HAMES-6-4th/smart-bus-access/docs/인터페이스 & 모듈 설계서/시스템 설계서.pdf

시스템 설계서 - Bluetooth기반 교통약자용 버스 전동문 및 전동경사로 소규모 통합 제어 시스템

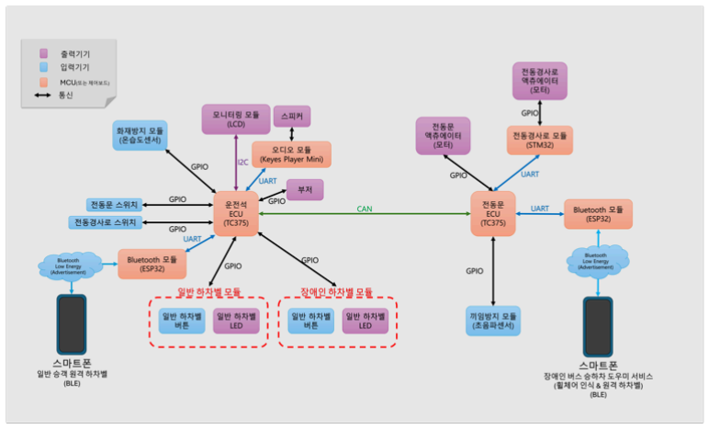
[picture p33: figure]
