HAMES-6-4th/smart-bus-access/docs/인터페이스 & 모듈 설계서/전동문 ECU.pdf

# 전동문 ECU - Bluetooth기반 교통약자용 버스 전동문 및 전동경사로 소규모 통 합 제어 시스템

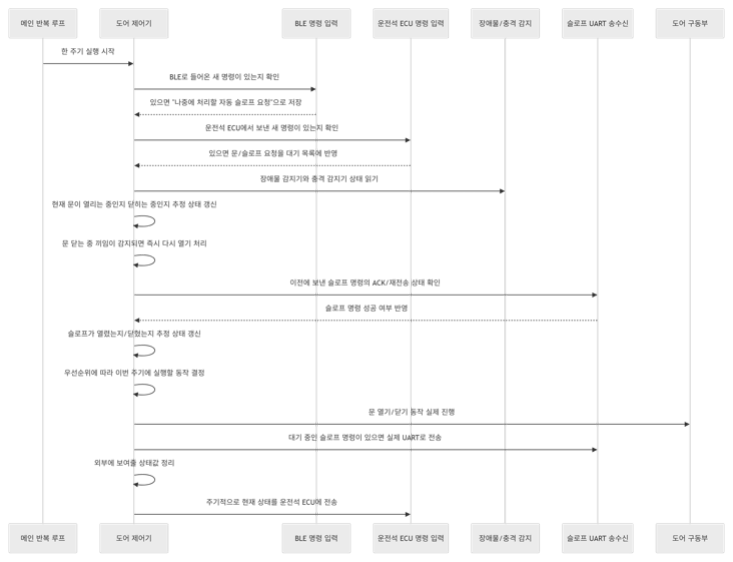
[picture p34: figure]

전체 시퀸스 다이어그램

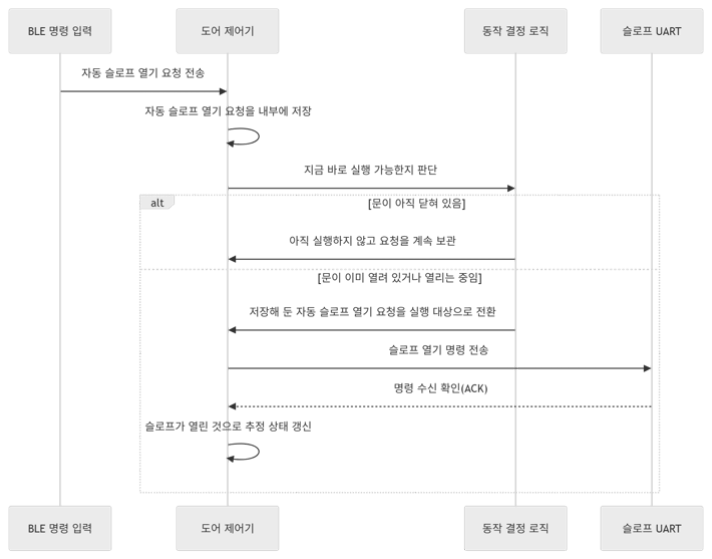
[picture p35: figure]

BLE 처리 구조

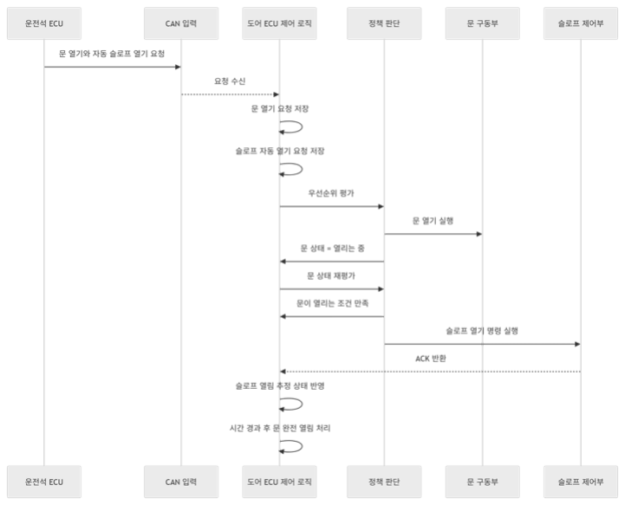
[picture p36: figure]

운전석 ECU에서 문 및 슬로프 열림 명령 수신 시

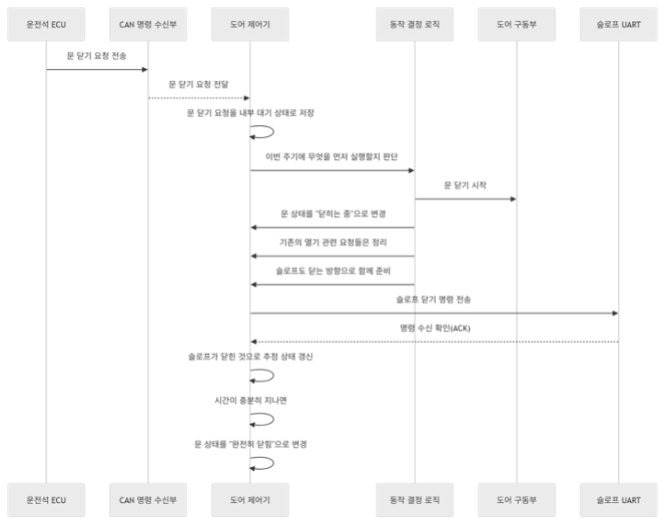
[picture p37: figure]

운전석 ECU에서 문 및 slope 닫힘 명령 수신 시

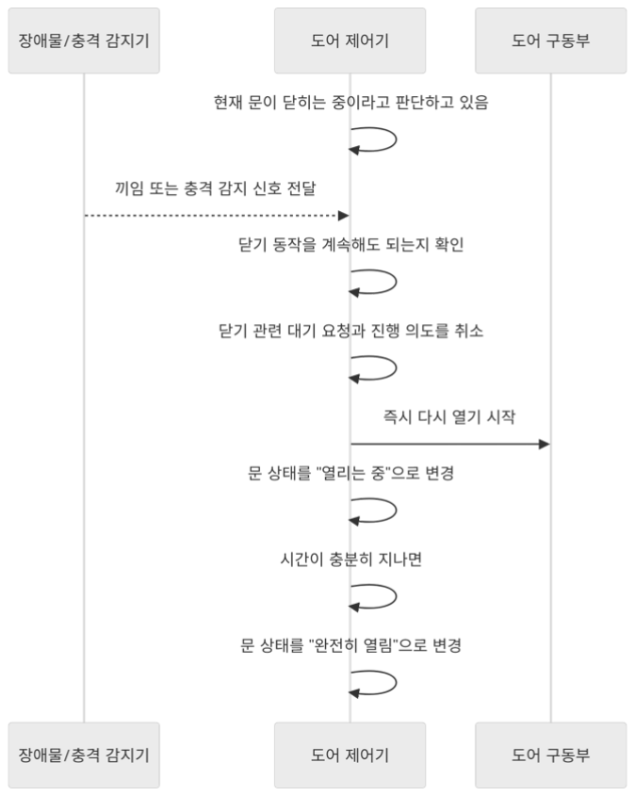
[picture p38: figure]

끼임 센서 다이어그램
