HAMES-6-4th/smart-bus-access/docs/인터페이스 & 모듈 설계서/핀 맵 & 레이아웃.pdf

핀 맵/레이아웃 - Bluetooth기반 교통약자용 버스 전동문 및 전동경사로 소규모 통합 제어 시스템

운전석 TC375 핀 맵

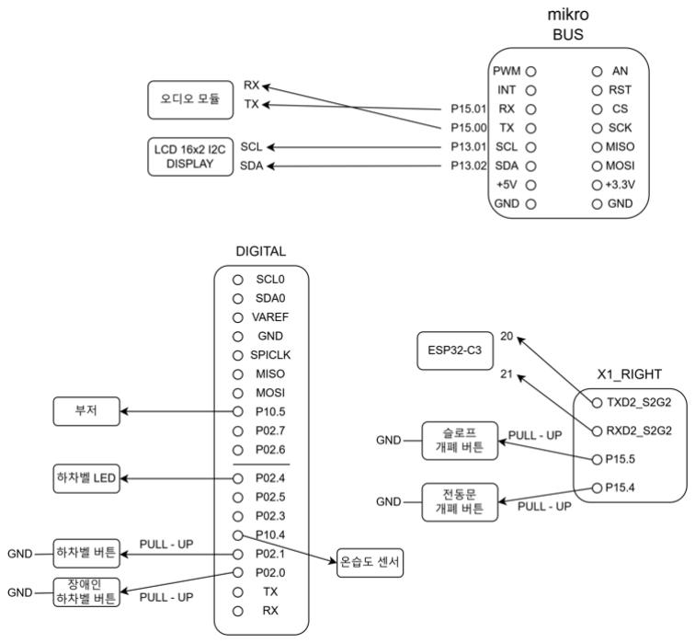
[picture p39: figure]
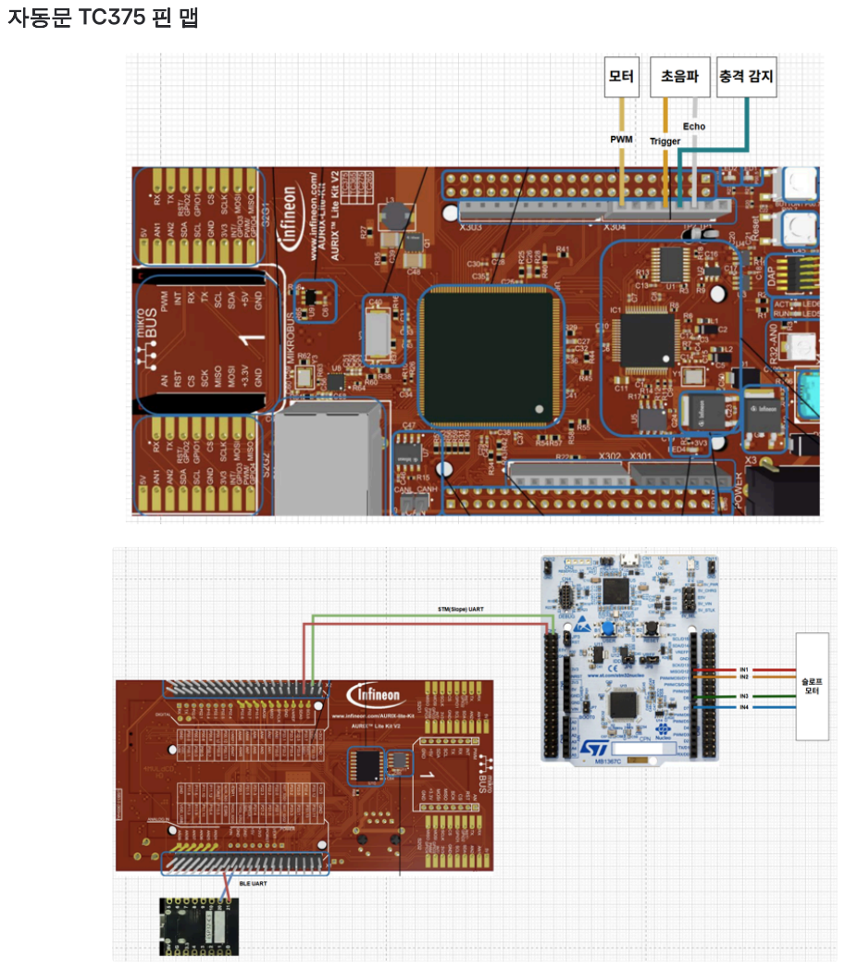
[picture p40: page 2]

자동문 TC375 핀 맵
