HAMES-6-4th/smart-bus-access/docs/최종 결과보고서/최종보고서.pdf

# Bluetooth기반 교통약자용

# 버스 전동문 및 전동경사로

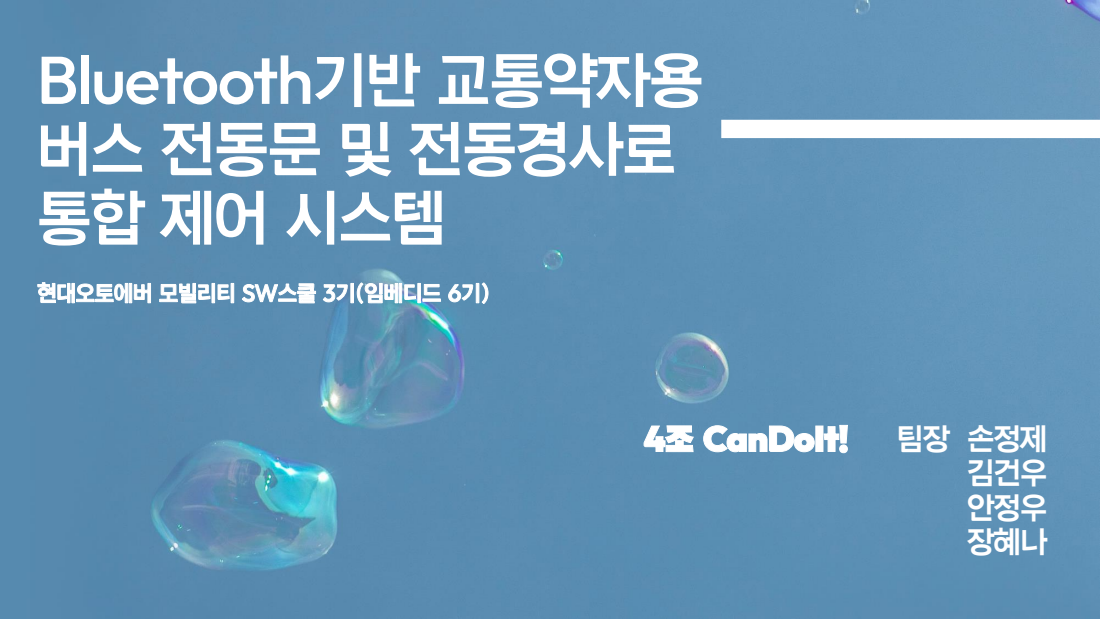
[picture p47: page 1]
4조 CanDoIt!; 팀장 손정제; 김건우 안정우 장혜나

통합 제어 시스템

현대오토에버 모빌리티 SW스쿨 3기(임베디드 6기)

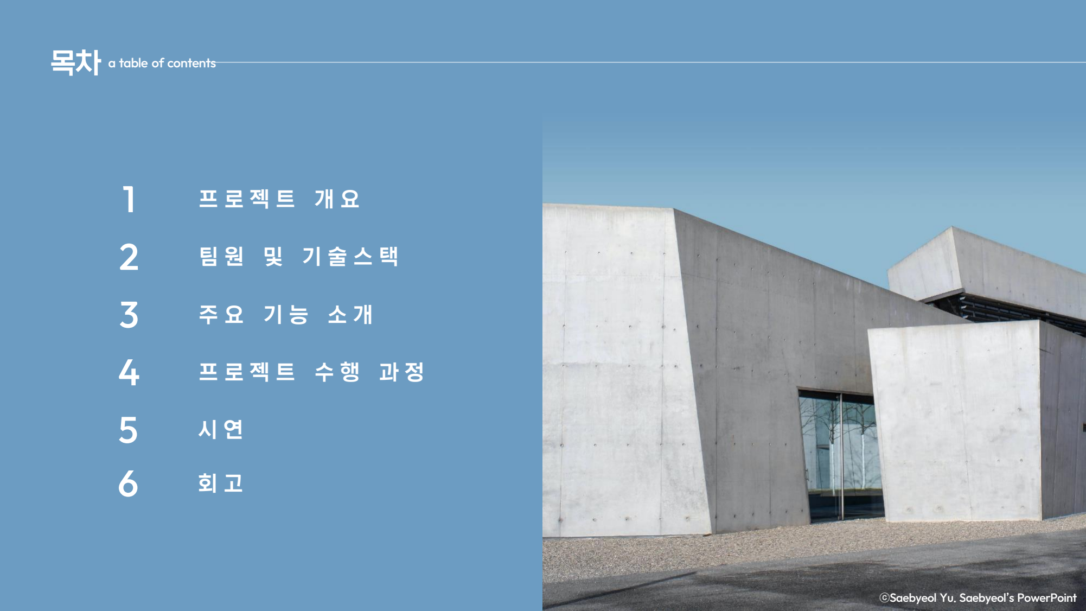
[picture p48: page 2]

목차

### 1 프로젝트 개요

### 2 팀원 및 기술스택

### 3 주요 기능 소개

### 4 프로젝트 수행 과정

a table of contents

ⓒSaebyeol Yu. Saebyeol’s PowerPoint

### 5 시연

## 6 회고

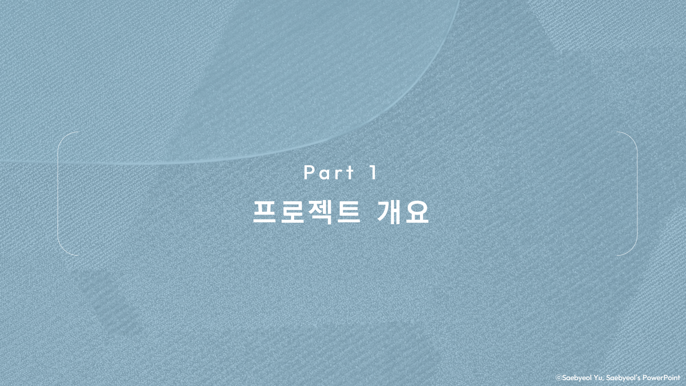
[picture p49: page 3]

P a r t 1

# 프로젝트 개요

ⓒSaebyeol Yu. Saebyeol’s PowerPoint

Part 1
프로젝트 개요

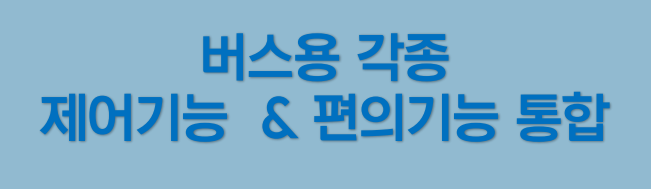
[picture p50: figure]
버스용 각종 제어기능 & 편의기능 통합
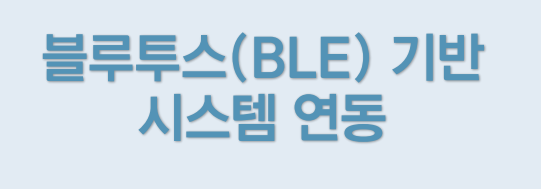
[picture p51: figure]
블루투스(BLE) 기반 시스템 연동

문 및 경사로 전동제어

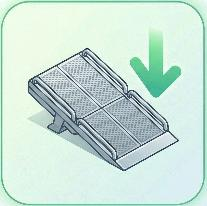
[picture p52: figure]
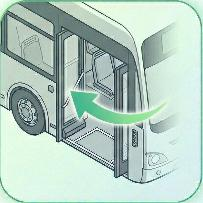
[picture p53: figure]
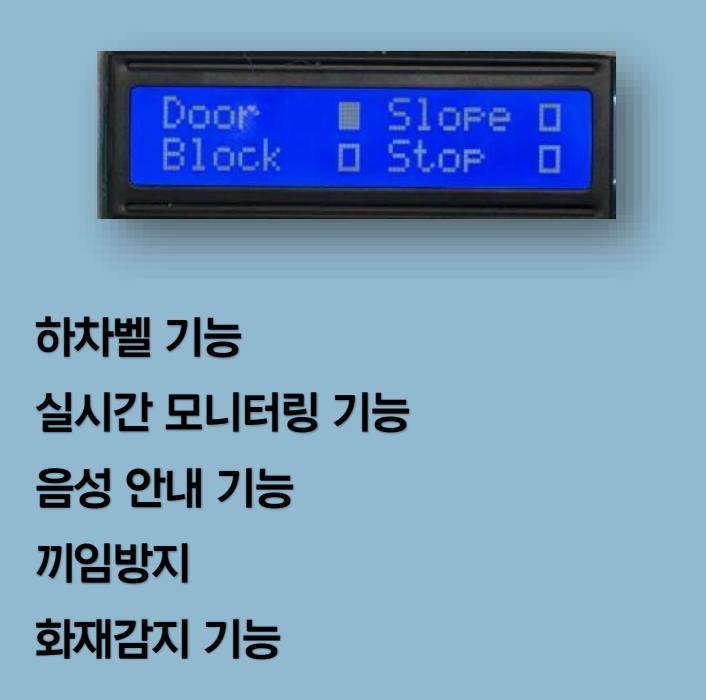
[picture p54: figure]
하차벨 기능; 실시간 모니터링 기능; 끼임방지; 화재감지 기능
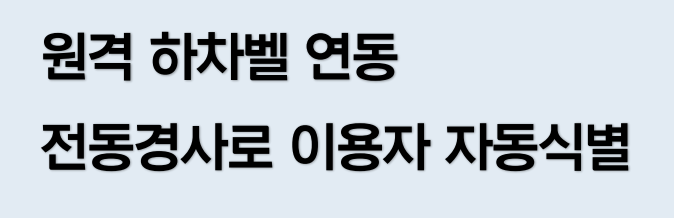
[picture p55: figure]
원격 하차벨 연동; 전동경사로 이용자 자동식별
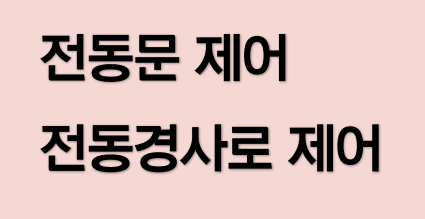
[picture p56: figure]
전동문 제어; 전동경사로 제어
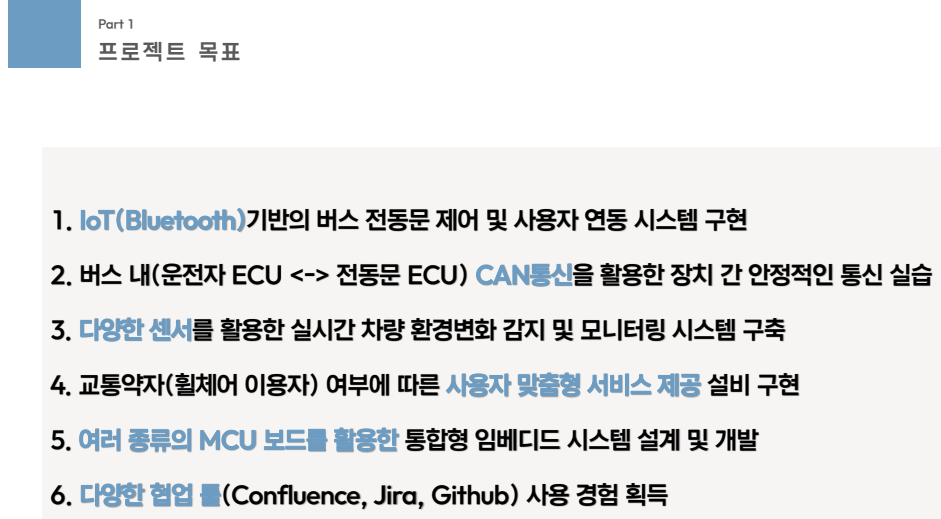
[picture p57: page 5]
Part 1 프로젝트 목표

1. IoT(Bluetooth)기반의 버스 전동문 제어 및 사용자 연동 시스템 구현

2. 버스 내(운전자 ECU <-> 전동문 ECU) CAN통신을 활용한 장치 간 안정적인 통신 실습

3. 다양한 센서를 활용한 실시간 차량 환경변화 감지 및 모니터링 시스템 구축

4. 교통약자(휠체어 이용자) 여부에 따른 사용자 맞춤형 서비스 제공 설비 구현

5. 여러 종류의 MCU 보드를 활용한 통합형 임베디드 시스템 설계 및 개발

6. 다양한 협업 툴(Confluence, Jira, Github) 사용 경험 획득

Part 1
프로젝트 기능 소개
BLE 기반 교통 약자 접근 인식 | 센서 기반 안전 전동문 제어

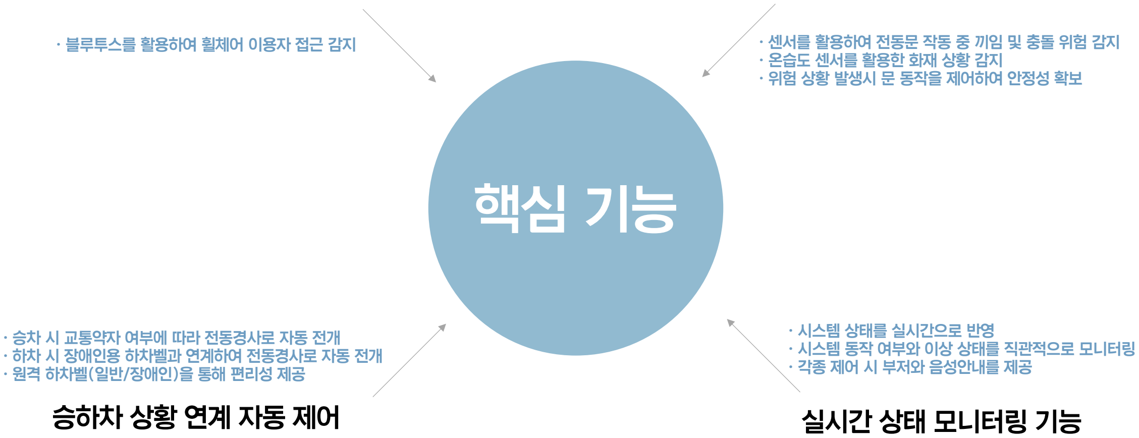
[picture p58: figure]
승하차 상황 연계 자동 제어; 실시간 상태 모니터링 기능; · 블루투스를 활용하여 휠체어 이용자 접근 감지; · 승차 시 교통약자 여부에 따라 전동경사로 자동 전개 · 하차 시 장애인용 하차벨과 연계하여 전동경사로 자동 전개 · 원격 하차벨(일반/장애인)을 통해 편리성 제공; · 센서를 활용하여 전동문 작동 중 끼임 및 충돌 위험 감지 · 온습도 센서를 활용한 화재 상황 감지 · 위험 상황 발생시 문 동작을 제어하여 안정성 확보; · 시스템 상태를 실시간으로 반영 · 시스템 동작 여부와 이상 상태를 직관적으로 모니터링 · 각종 제어 시 부저와 음성안내를 제공

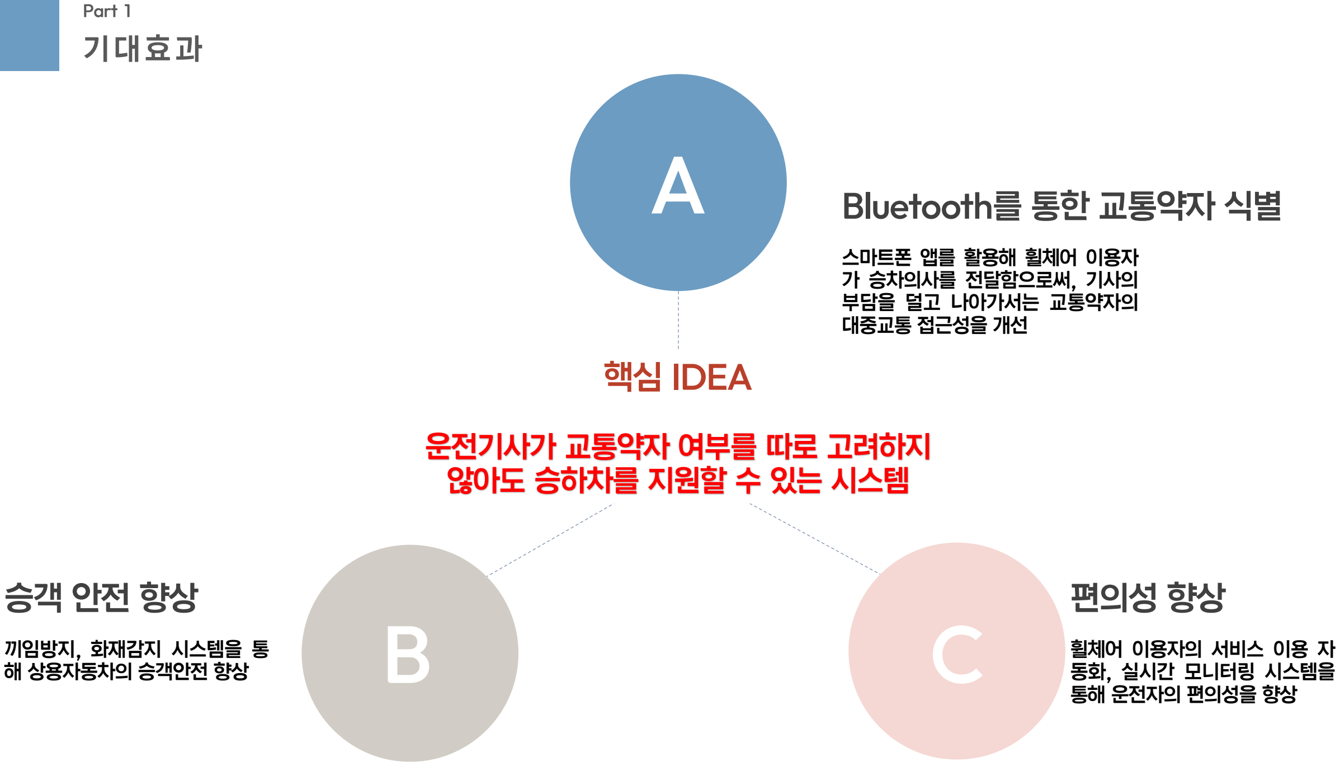
[picture p59: figure]
Part 1 기대효과; 끼임방지 해 상용자동차의; , 화재감지 승객안전; 시스템을 향상; 휠체어 이용자의 서비스 이용 자 동화, 실시간 모니터링 시스템을 통해 운전자의 편의성을 향상; 편의성 향상; 스마트폰 앱를 활용해 휠체어 이용자 가 승차의사를 전달함으로써, 기사의 부담을 덜고 나아가서는 교통약자의 대중교통 접근성을 개선; Bluetooth를 통한 교통약자 식별; 핵심 IDEA; 운전기사가 교통약자 여부를 따로 고려하지 않아도 승하차를 지원할 수 있는 시스템
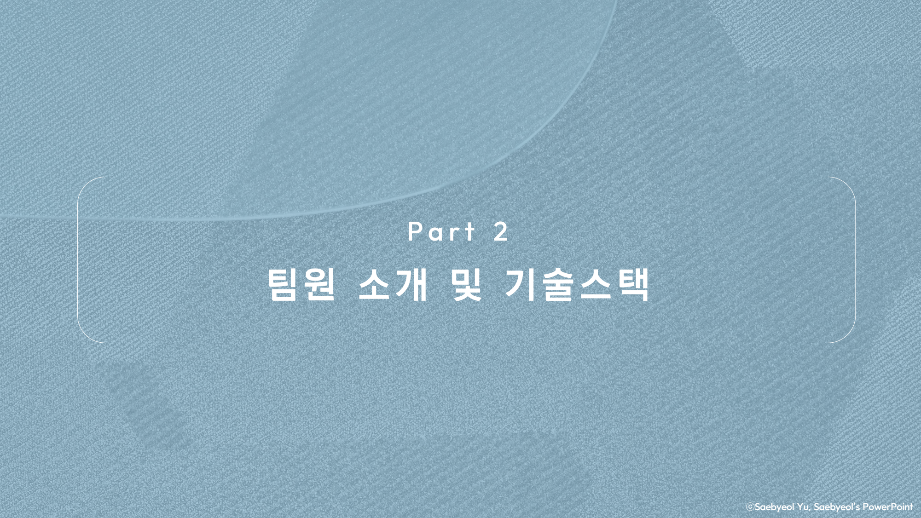
[picture p60: page 8]

P a r t 2

# 팀원 소개 및 기술스택

ⓒSaebyeol Yu. Saebyeol’s PowerPoint

Part 2
팀원 소개

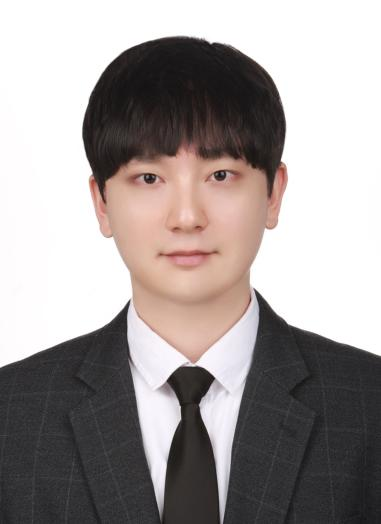
[picture p61: figure]

### 손정제

- 팀장
- 메인 ECU 제어 로직
- 하차벨 기능
- 끼임방지 기능

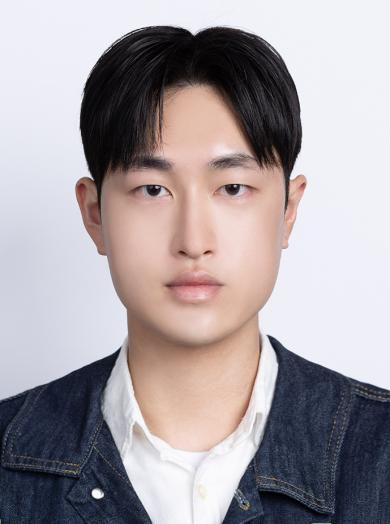
[picture p62: figure]

### 김건우

- 협업툴&산출물 관리
- 오디오 모듈
- 모니터링 모듈
- 화재방지 모듈

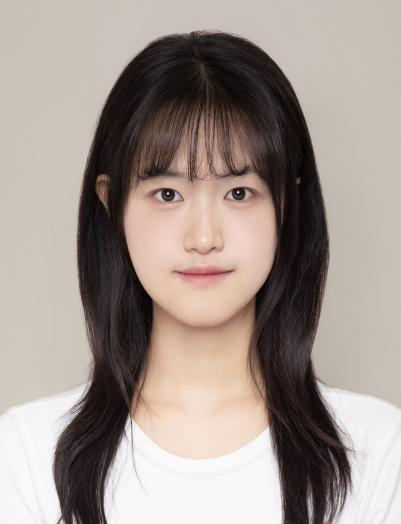
[picture p63: figure]

### 장혜나

- 하드웨어 설계
- 기구물 설계및제작
- 전동문 제어모듈
- 전동경사로 제어모듈

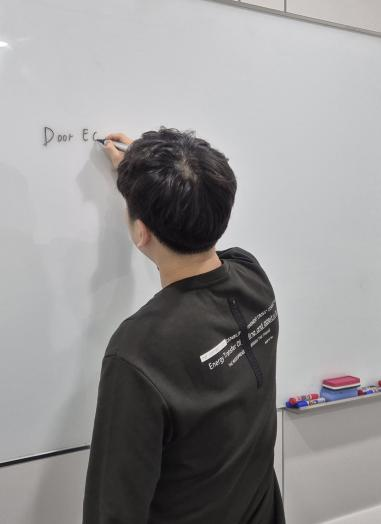
[picture p64: figure]

### 안정우

- CAN 통신 모듈
- Bluetooth 모듈
- 사용자 App 제작
- 전동문 ECU 제어로직

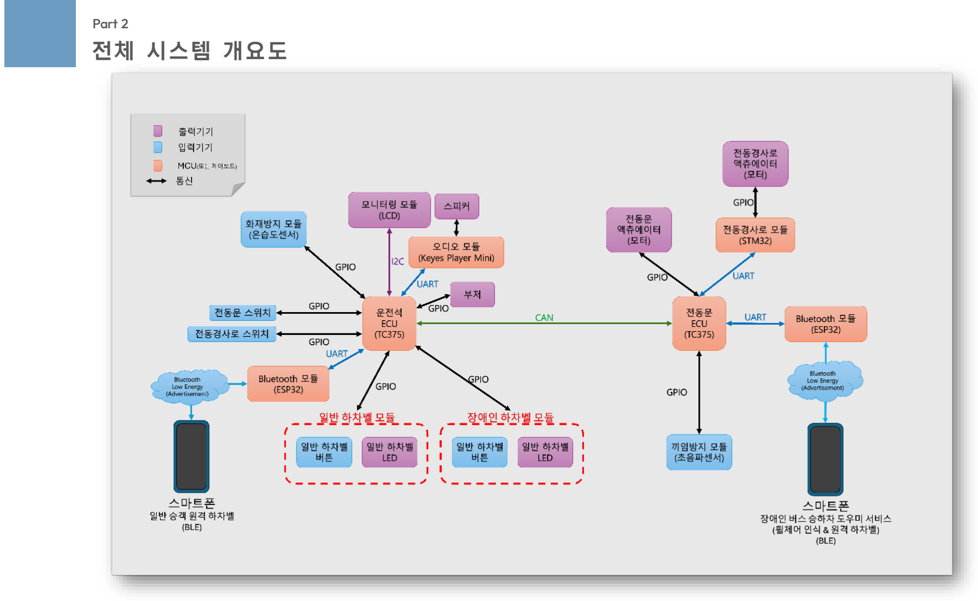
[picture p65: page 10]

Part 2
전체 시스템 개요도

Part 2
개발 환경 및 스택

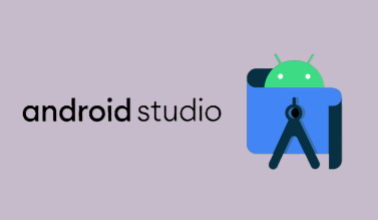
[picture p66: figure]

### 개발 Tool

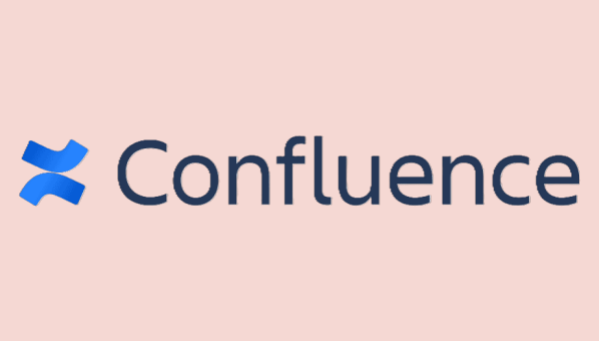
[picture p67: figure]

형상관리 Tool | 하드웨어(MCU) 협업 Tool

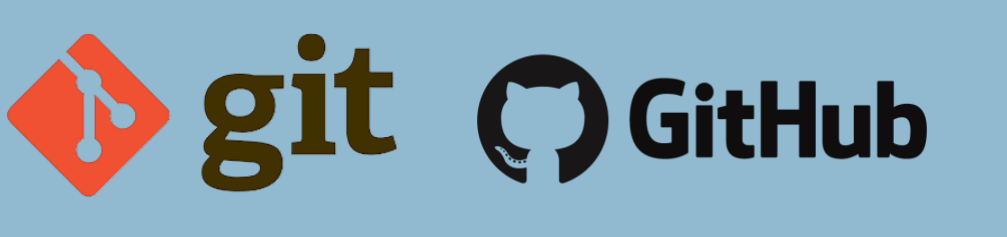
[picture p68: figure]
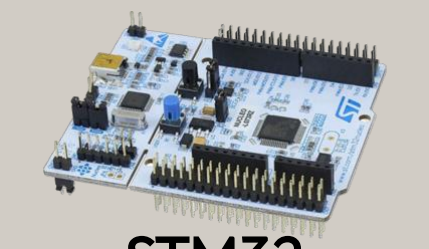
[picture p69: figure]

TC375 | STM32 | ESP32-C3

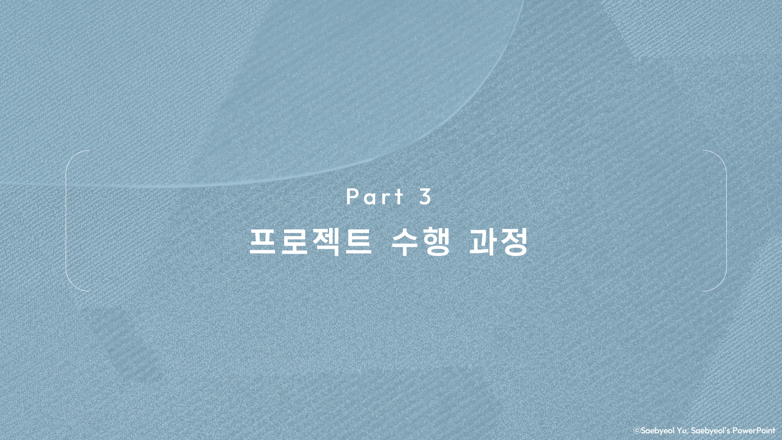
[picture p70: page 12]

P a r t 3

# 프로젝트 수행 과정

ⓒSaebyeol Yu. Saebyeol’s PowerPoint

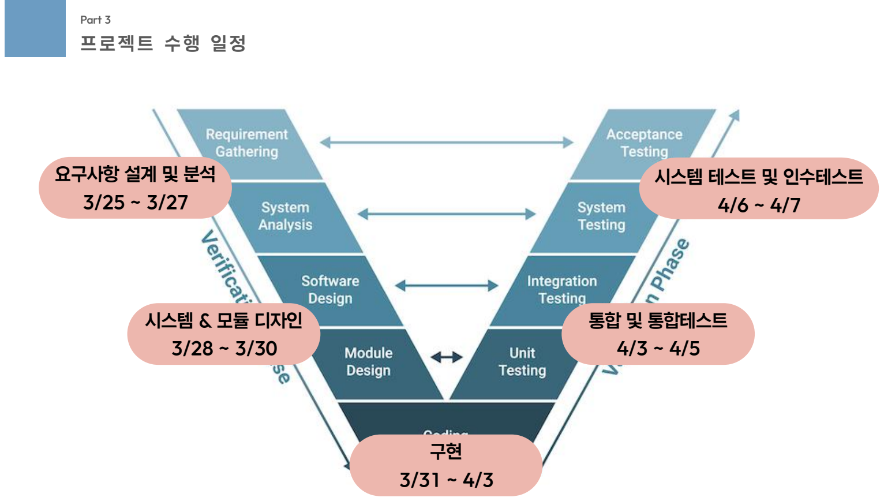
[picture p71: page 13]

Part 3
프로젝트 수행 일정

요구사항 설계 및 분석
3/25 ~ 3/27

시스템 & 모듈 디자인
3/28 ~ 3/30

구현
3/31 ~ 4/3

통합 및 통합테스트
4/3 ~ 4/5

시스템 테스트 및 인수테스트
4/6 ~ 4/7

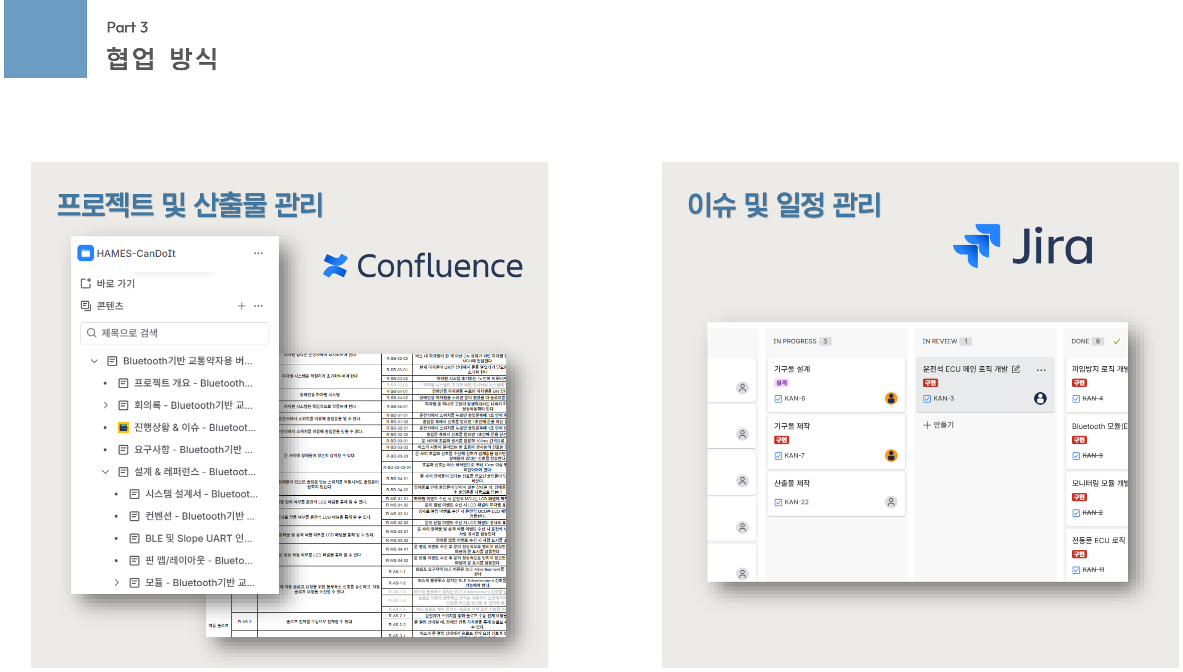
[picture p72: page 14]

협업 방식

프로젝트 및 산출물 관리 | 이슈 및 일정 관리

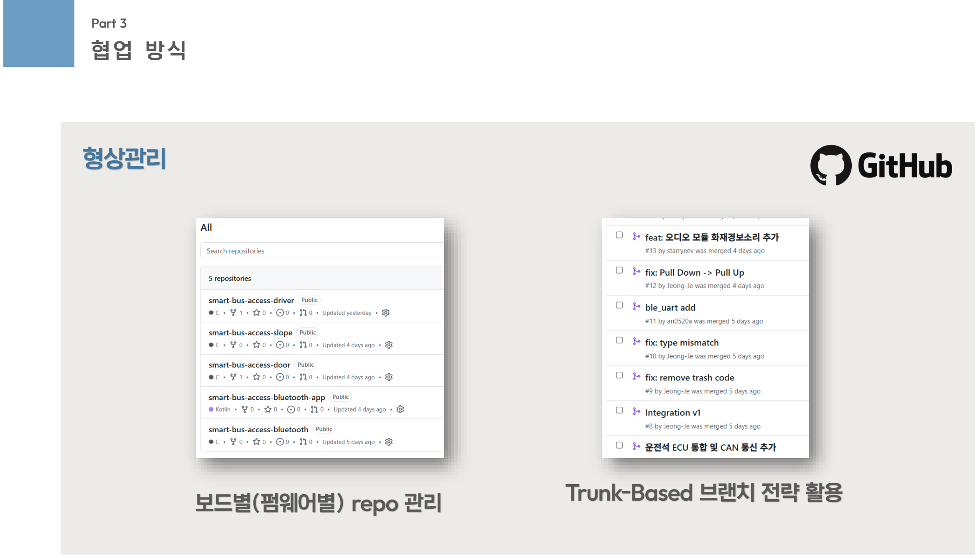
[picture p73: page 15]

협업 방식

형상관리

보드별(펌웨어별) repo 관리 | Trunk-Based 브랜치 전략 활용

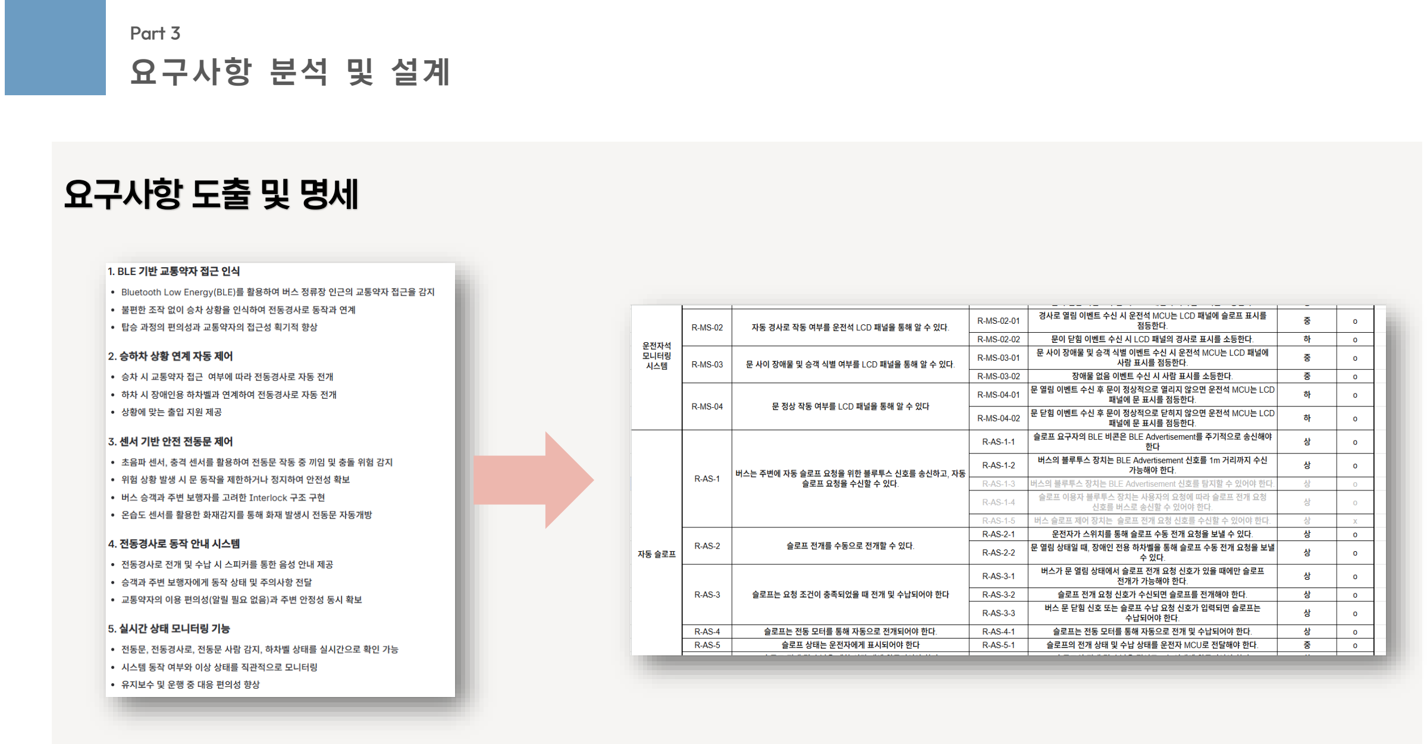
[picture p74: page 16]

요구사항 분석 및 설계

요구사항 도출 및 명세

주요 기능 및 모듈 소개 – 전동문 & 전동경사로

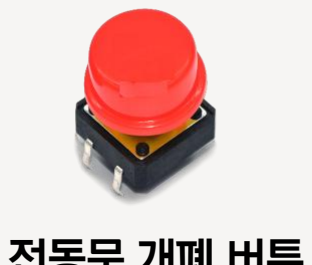
[picture p75: figure]
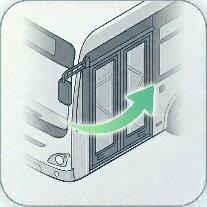
[picture p76: figure]
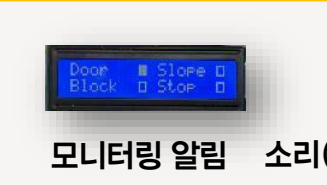
[picture p77: figure]
모니터링 알림
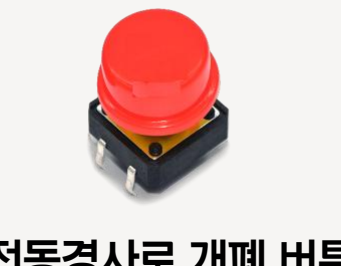
[picture p78: figure]
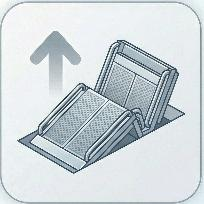
[picture p79: figure]
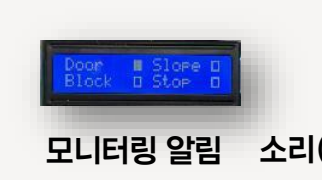
[picture p80: figure]
모니터링 알림

전동경사로 개폐 버튼 | 전동경사로 자동 전개 | 전동경사로 수납 (수동모드) | 소리(음성) 알림
소리(음성) 알림 | 전동문 개방 | 전동문 폐쇄

전동문 개폐 버튼

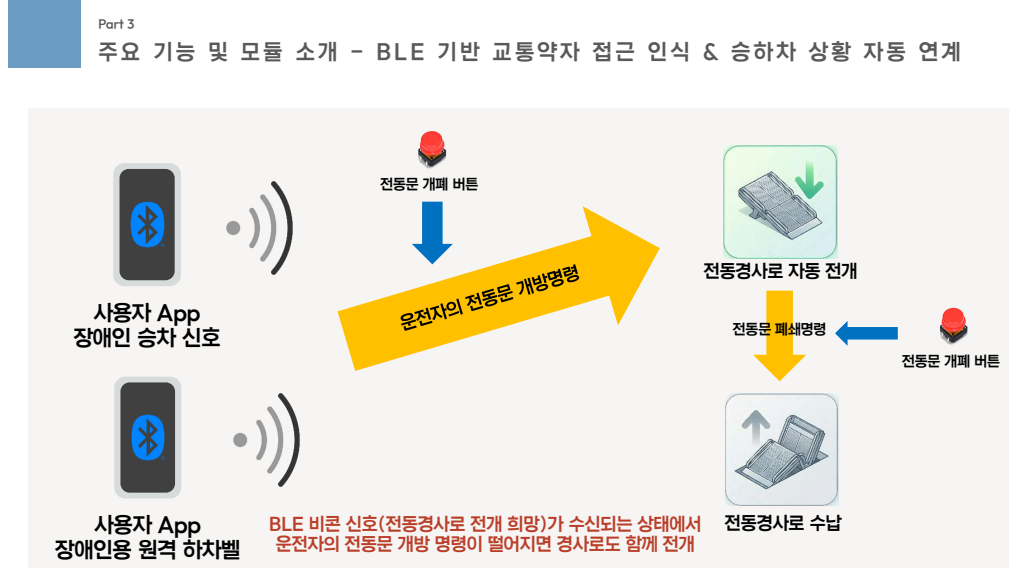
[picture p81: page 18]
전동경사로 수납; 전동문 폐쇄명령

주요 기능 및 모듈 소개 – B L E 기반 교통약자 접근 인식 & 승하차 상황 자동 연계

전동문 개폐 버튼

전동경사로 자동 전개

사용자 App
장애인 승차 신호

장애인용 원격 하차벨

BLE 비콘 신호(전동경사로 전개 희망)가 수신되는 상태에서
운전자의 전동문 개방 명령이 떨어지면 경사로도 함께 전개

주요 기능 및 모듈 소개 – 안전 전동문 제어 시스템

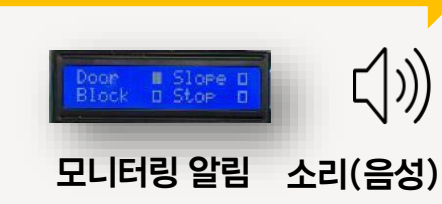
[picture p82: figure]
모니터링 알림

소리(음성) 알림 전동문 자동 개방

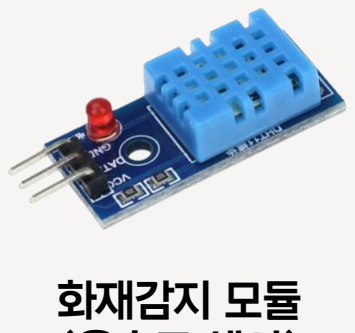
[picture p83: figure]
화재감지 모듈

(온습도 센서)

알고리즘에 따른 화재 감지

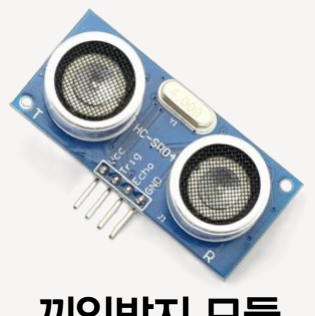
[picture p84: figure]

끼임방지 모듈

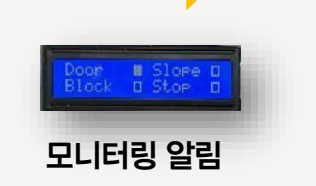
[picture p85: figure]
모니터링 알림

(초음파 센서) | 전동문 자동 개방

알고리즘에 따른 장애물 감지

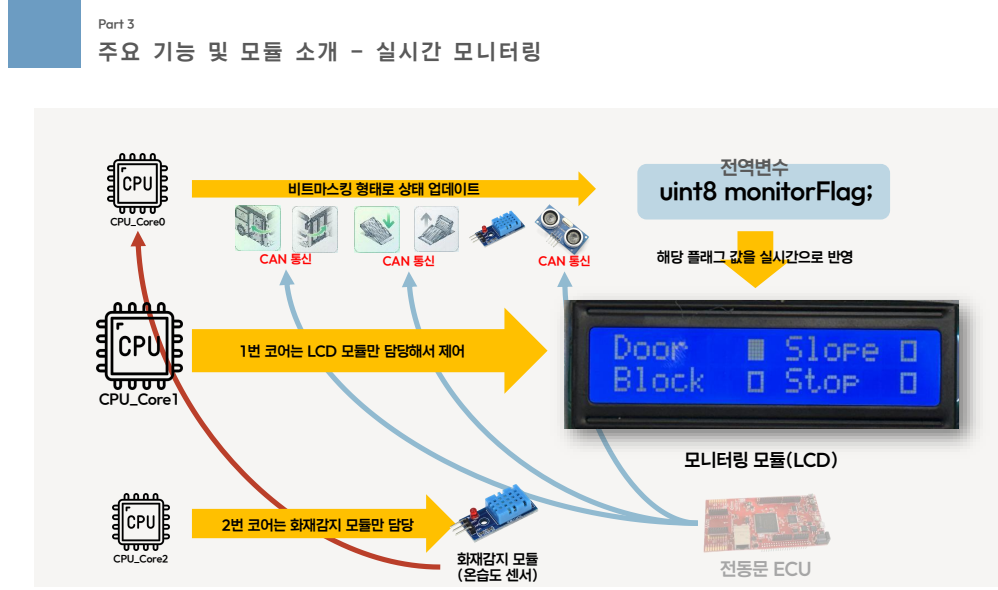
[picture p86: page 20]
CPU_Core0; CPU_Core2; 비트마스킹 형태로 상태 업데이트; uint8 monitorFlag;; 전역변수; CAN 통신; CPU_Core1

주요 기능 및 모듈 소개 – 실시간 모니터링

해당 플래그 값을 실시간으로 반영

1번 코어는 LCD 모듈만 담당해서 제어

모니터링 모듈(LCD)

2번 코어는 화재감지 모듈만 담당

전동문 ECU 화재감지 모듈
(온습도 센서)

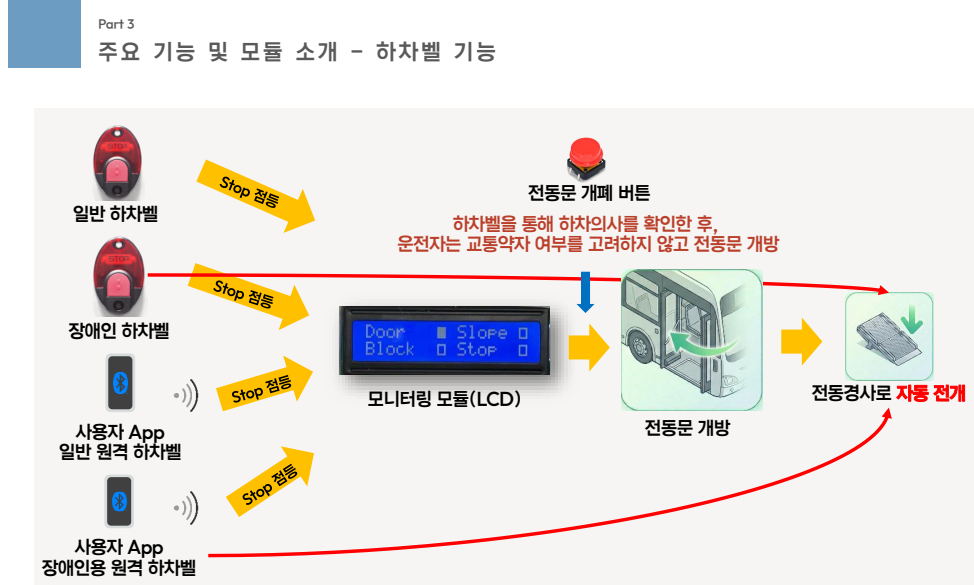
[picture p87: page 21]
일반 하차벨; 모니터링 모듈(LCD); 전동경사로 자동 전개; 장애인 하차벨; 전동문 개방

주요 기능 및 모듈 소개 – 하차벨 기능

전동문 개폐 버튼

하차벨을 통해 하차의사를 확인한 후,
운전자는 교통약자 여부를 고려하지 않고 전동문 개방

사용자 App
일반 원격 하차벨

장애인용 원격 하차벨

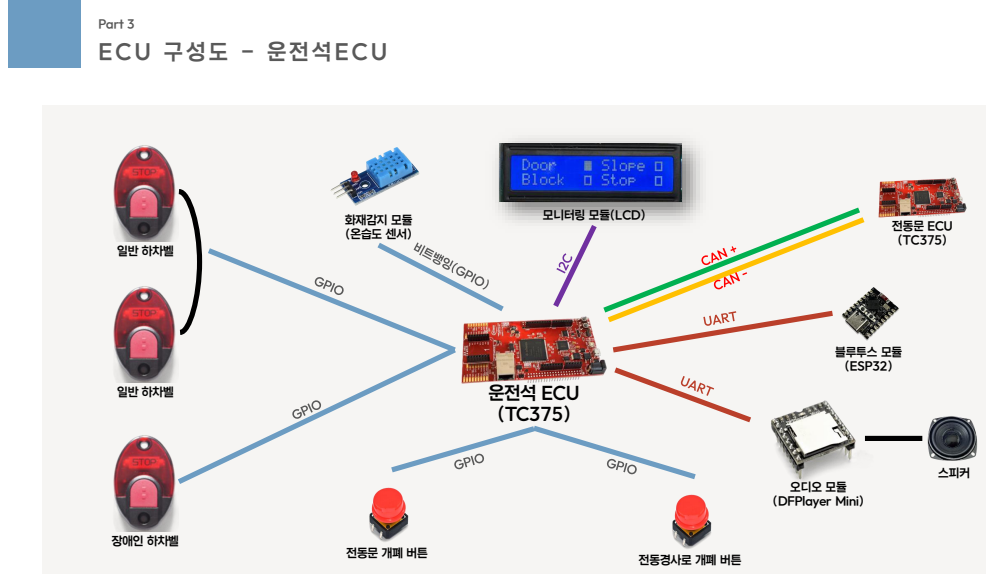
[picture p88: page 22]
블루투스 모듈 (ESP32); 일반 하차벨; 장애인 하차벨; 화재감지 모듈 (온습도 센서); 전동문 개폐 버튼; 전동경사로 개폐 버튼; 운전석 ECU (TC375); 오디오 모듈 (DFPlayer Mini); 스피커; 전동문 ECU (TC375)

E C U 구성도 – 운전석 ECU

모니터링 모듈(LCD)

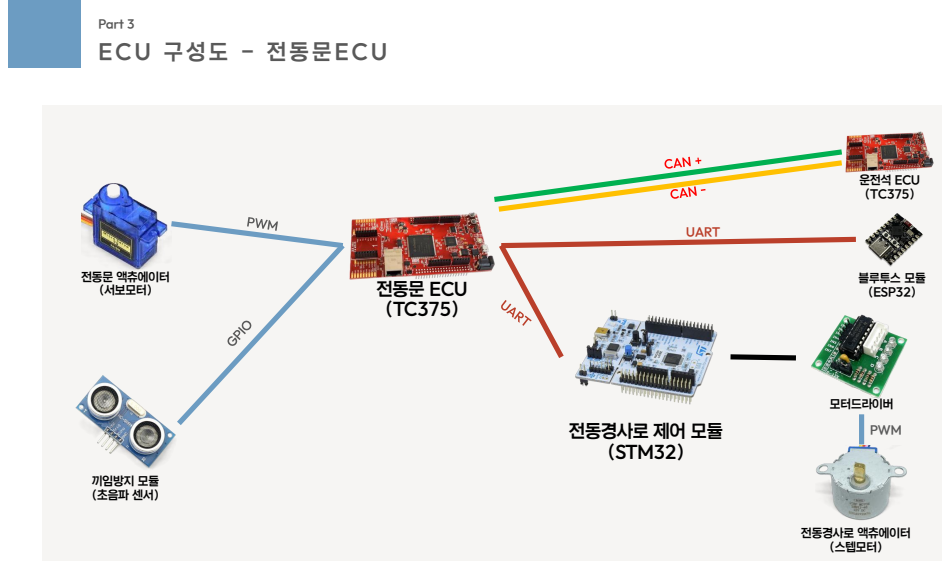
[picture p89: page 23]
블루투스 모듈 전동문 ECU; (ESP32); UART; 운전석 ECU (TC375); 전동문 액츄에이터 (서보모터); 끼임방지 모듈 (초음파 센서); 모터드라이버; 전동경사로 액츄에이터 (스텝모터); PWM

E C U 구성도 – 전동문 ECU

전동경사로 제어 모듈
(STM32)

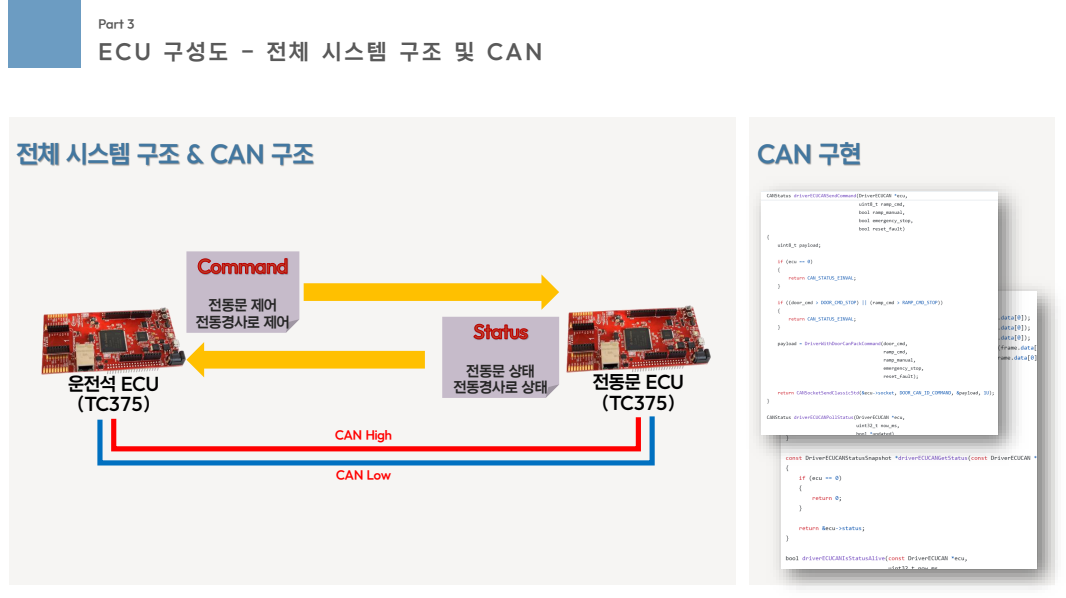
[picture p90: page 24]
운전석 ECU (TC375); 전동문 ECU (TC375); CAN High; CAN Low; Command; 전동문 제어; 전동경사로 제어; Status; 전동문 상태 전동경사로 상태; CAN 구현

E C U 구성도 – 전체 시스템 구조 및 CA N

전체 시스템 구조 & CAN 구조

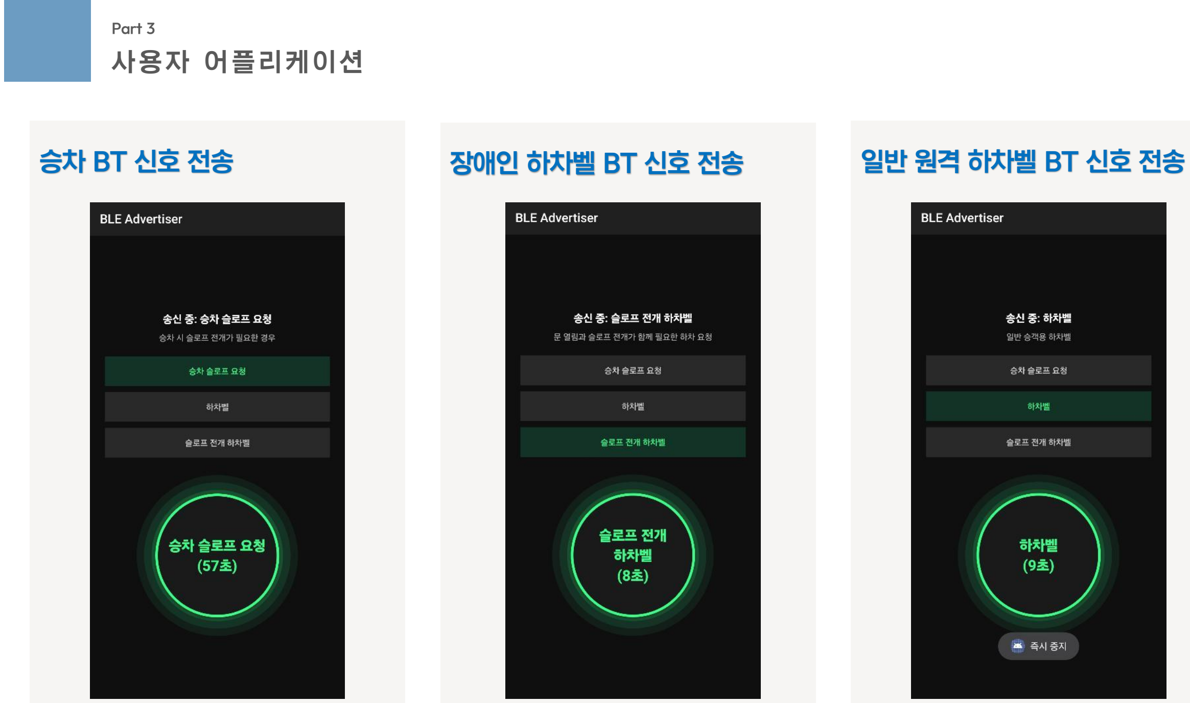
[picture p91: page 25]

사용자 어플리케이션

승차 BT 신호 전송 | 장애인 하차벨 BT 신호 전송 | 일반 원격 하차벨 BT 신호 전송

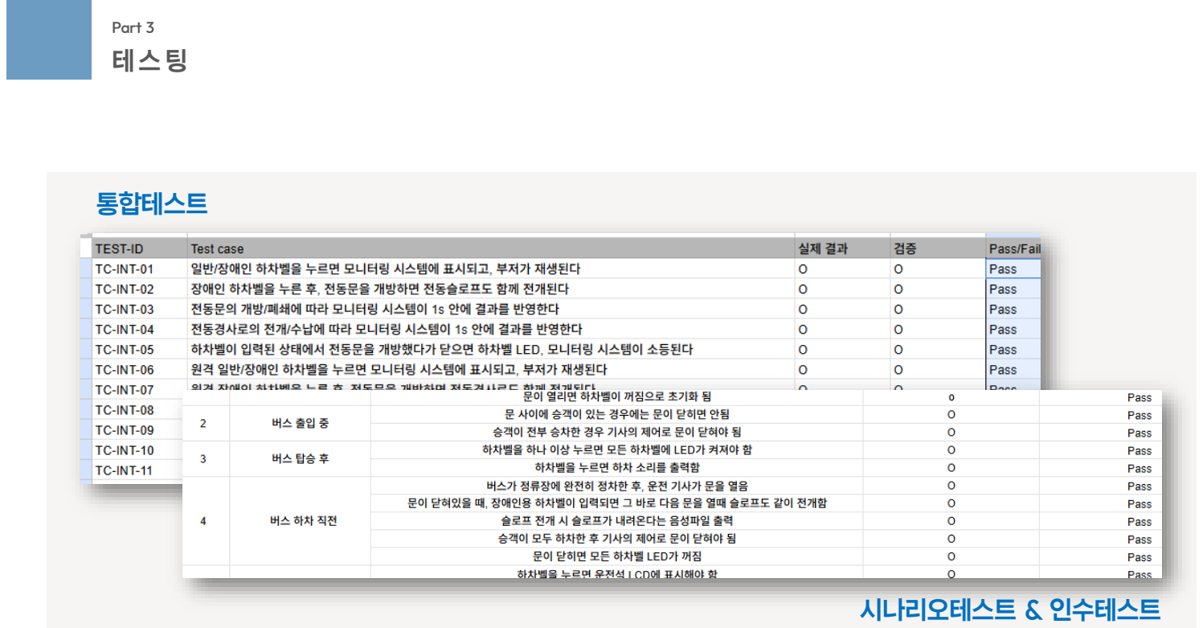
[picture p92: page 26]

테스팅

통합테스트

시나리오테스트 & 인수테스트

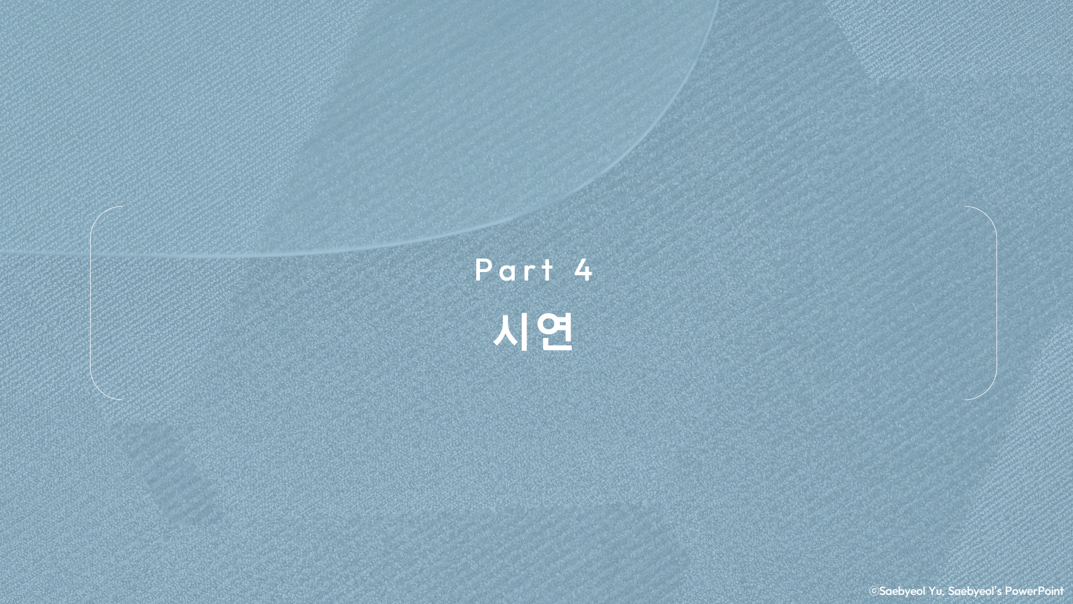
[picture p93: page 27]

P a r t 4
시연

ⓒSaebyeol Yu. Saebyeol’s PowerPoint

Part 4
시연

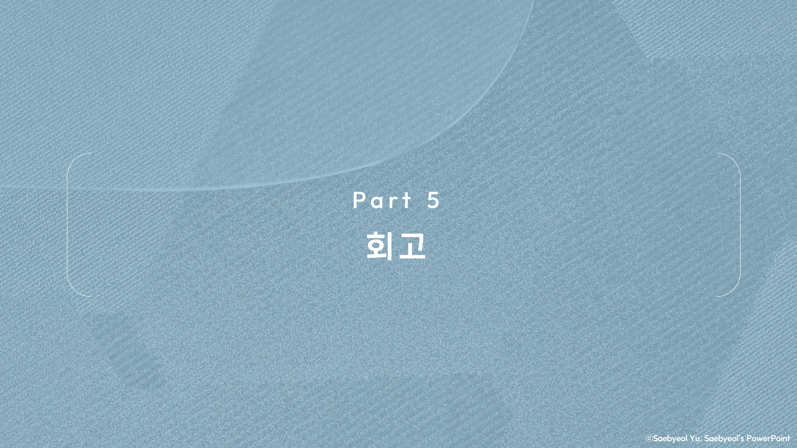
[picture p94: page 29]

P a r t 5
회고

ⓒSaebyeol Yu. Saebyeol’s PowerPoint

회고 – 안정제 ( 팀장 )

총평

- 팀장으로서 책임감을 느끼며 프로젝트를 완성했고, 통합 과정의 어려움을 몸소 경험한 의미 있는 시

간이었다.

- 좋은 팀원들과 협업하며 MCU를 깊이 있게 다뤄본 경험이 인상적이었다.

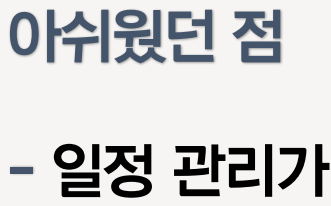
[picture p95: figure]
아쉬웠던 점

- 일정 관리가 부족했던 점이 아쉬웠고, 팀장으로서 이를 더 잘 이끌지 못한 점에 책임을 느낀다.

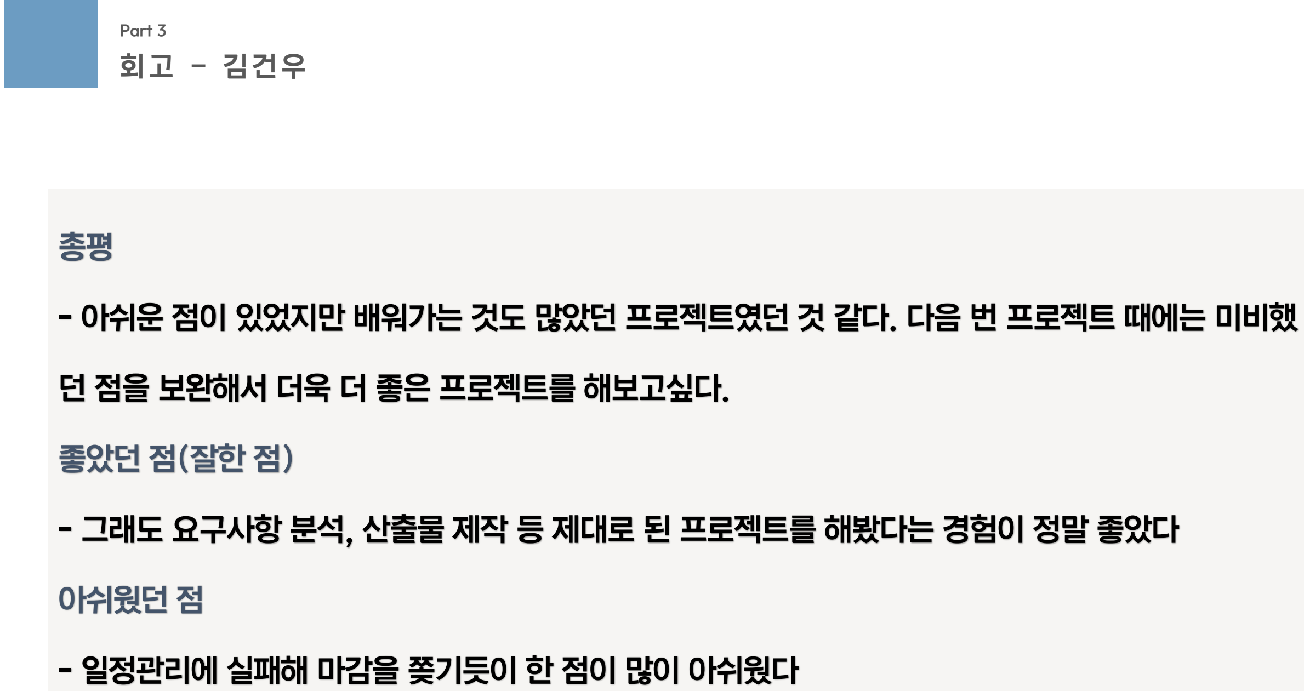
[picture p96: page 31]

회고 – 김건우

총평

- 아쉬운 점이 있었지만 배워가는 것도 많았던 프로젝트였던 것 같다. 다음 번 프로젝트 때에는 미비했

던 점을 보완해서 더욱 더 좋은 프로젝트를 해보고싶다.

좋았던 점(잘한 점)

- 그래도 요구사항 분석, 산출물 제작 등 제대로 된 프로젝트를 해봤다는 경험이 정말 좋았다

아쉬웠던 점

- 일정관리에 실패해 마감을 쫒기듯이 한 점이 많이 아쉬웠다

회고 – 장혜나

총평

- 역할을 나누어 협업하며 프로젝트를 완수한 것이 매우 뜻깊은 경험이었다.

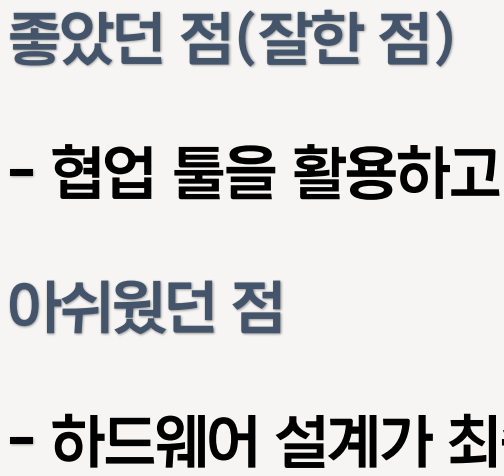
[picture p97: figure]
좋았던 점(잘한 점); 아쉬웠던 점

- 협업 툴을 활용하고 각자의 역할에 집중하며 실제 개발 프로세스를 경험할 수 있었다.
- 하드웨어 설계가 최종적으로 안정적으로 동작하지 않아 아쉬움이 남았다

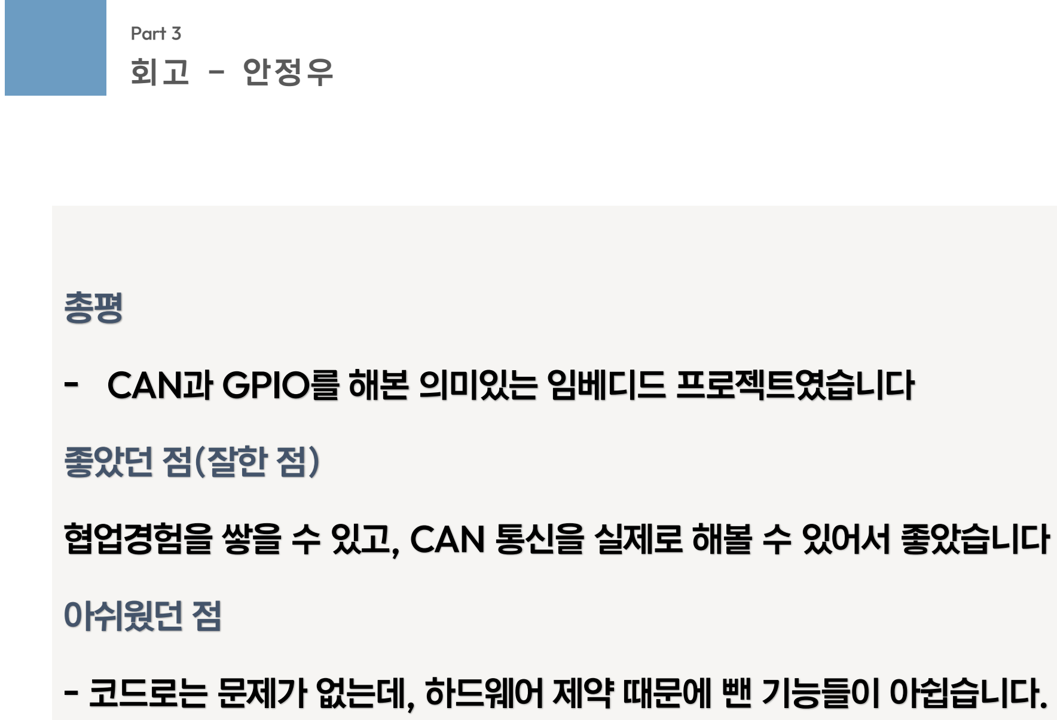
[picture p98: page 33]

회고 – 안 정우

총평

- CAN과 GPIO를 해본 의미있는 임베디드 프로젝트였습니다

좋았던 점(잘한 점)

협업경험을 쌓을 수 있고, CAN 통신을 실제로 해볼 수 있어서 좋았습니다

아쉬웠던 점

- 코드로는 문제가 없는데, 하드웨어 제약 때문에 뺀 기능들이 아쉽습니다.

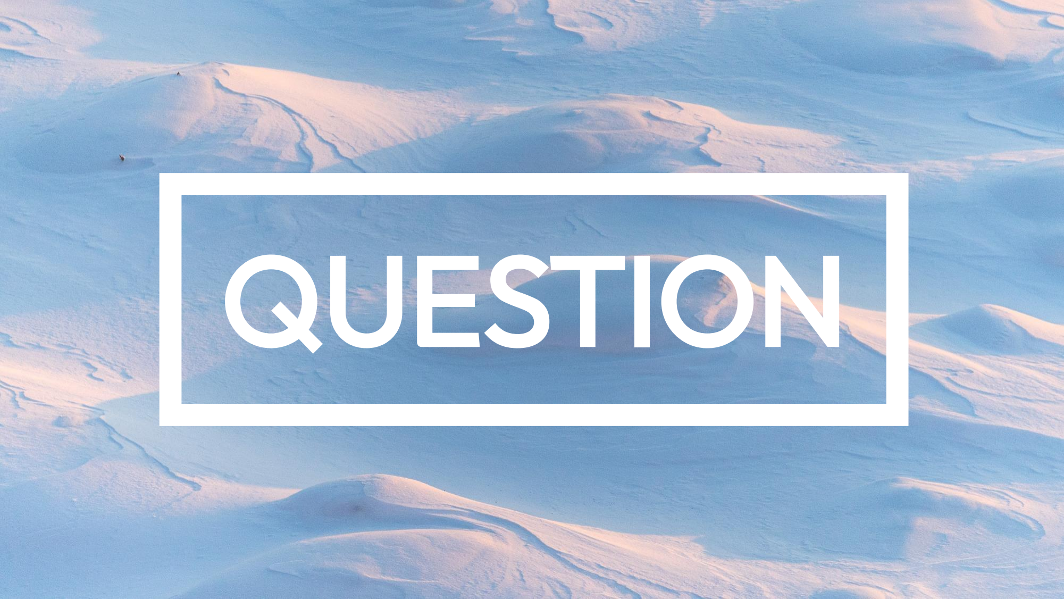
[picture p99: page 34]

# QUESTION

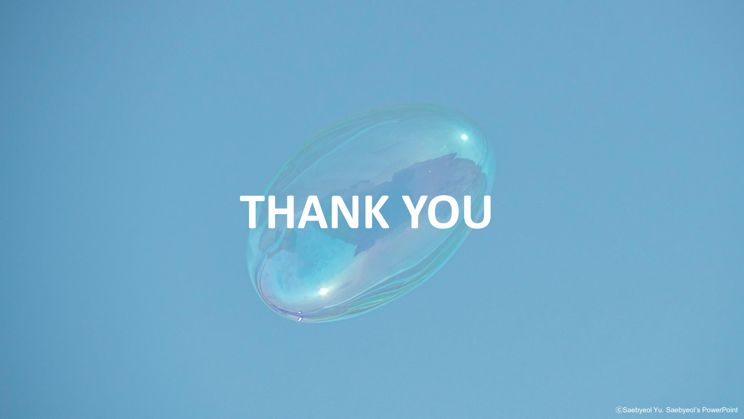
[picture p100: page 35]

# THANK YOU

ⓒSaebyeol Yu. Saebyeol’s PowerPoint
