HAMES-6-4th/smart-bus-access/docs/인터페이스 & 모듈 설계서/모니터링 모듈.pdf

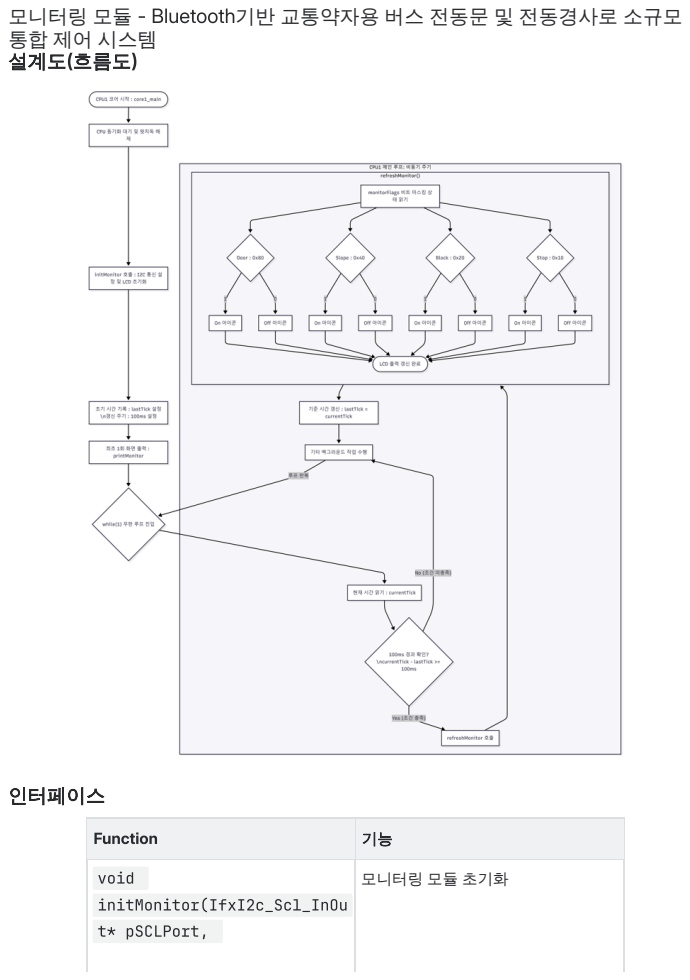
[picture p101: page 1]
인터페이스; void; initMonitor(IfxI2c_Scl_InOu; t* pSCLPort,; Function

모니터링 모듈 - Bluetooth기반 교통약자용 버스 전동문 및 전동경사로 소규모
통합 제어 시스템
설계도(흐름도)

모니터링 모듈 초기화

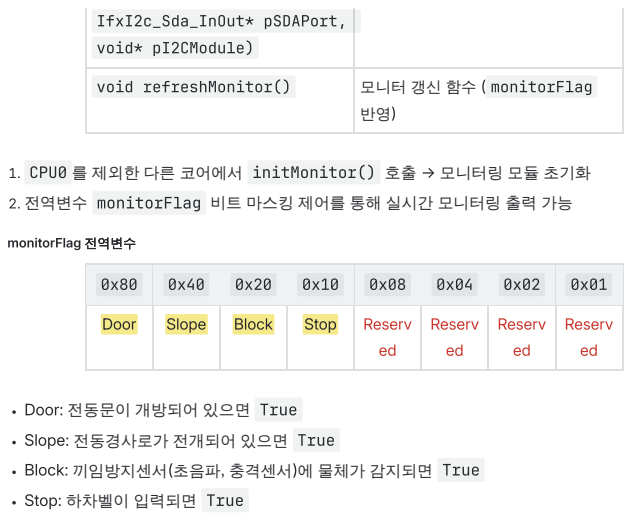
[picture p102: page 2]
monitorFlag 전역변수; IfxI2c_Sda_InOut* pSDAPort,; void* pI2CModule); void refreshMonitor(); 모니터 갱신 함수 ( monitorFlag

1. CPU0 를 제외한 다른 코어에서 initMonitor() 호출 → 모니터링 모듈 초기화
2. 전역변수 monitorFlag 비트 마스킹 제어를 통해 실시간 모니터링 출력 가능

Door | Slope | Block | Stop | Reserv ed | Reserv ed | Reserv ed | Reserv ed

Door: 전동문이 개방되어 있으면 True
Slope: 전동경사로가 전개되어 있으면 True
Block: 끼임방지센서(초음파, 충격센서)에 물체가 감지되면 True
Stop: 하차벨이 입력되면 True
