HAMES-6-4th/smart-bus-access/docs/인터페이스 & 모듈 설계서/오디오 모듈.pdf

# 오디오 모듈 - Bluetooth기반 교통약자용 버스 전동문 및 전동경사로 소규모 통 합 제어 시스템

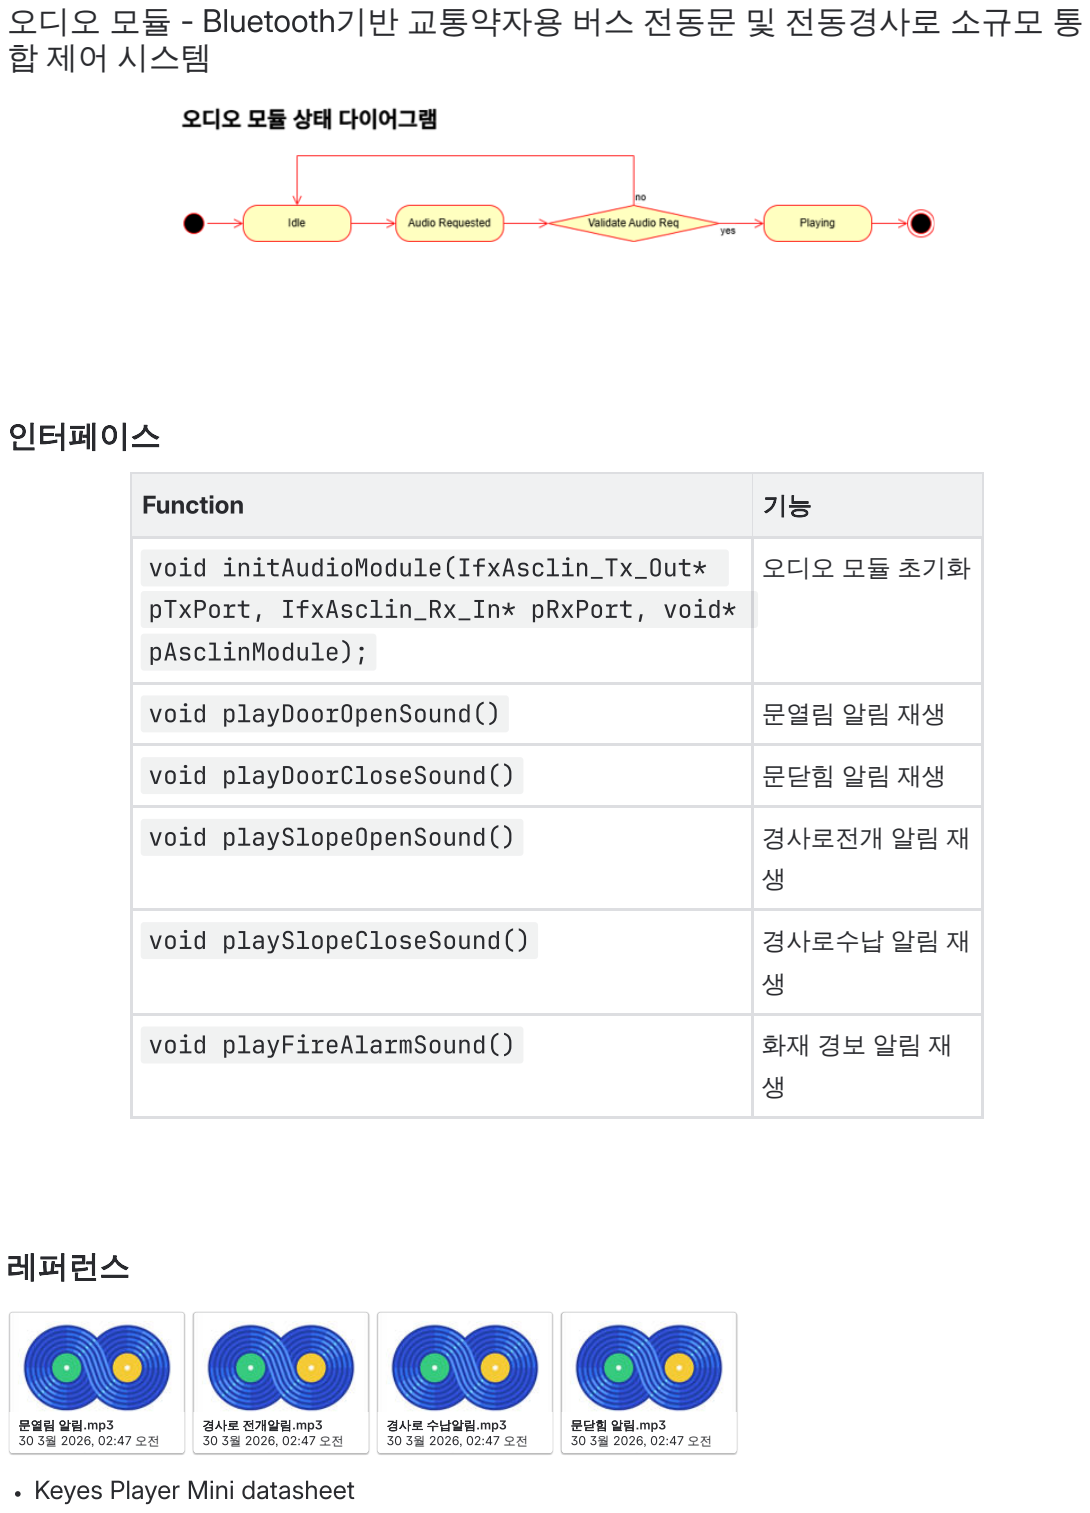
[picture p103: page 1]
인터페이스; 레퍼런스; 문열림 알림.mp3; 경사로 전개; 경사로 수납; 문닫힘 알림.mp3

Function | 기능

void initAudioModule(IfxAsclin_Tx_Out* pTxPort, IfxAsclin_Rx_In* pRxPort, void* pAsclinModule); | 오디오 모듈 초기화

void playDoorOpenSound() | 문열림 알림 재생

void playDoorCloseSound() | 문닫힘 알림 재생

void playSlopeOpenSound() | 경사로전개 알림 재 생

void playSlopeCloseSound() | 경사로수납 알림 재 생

void playFireAlarmSound() | 화재 경보 알림 재 생

Keyes Player Mini datasheet

KE0092 Keyes Player Mini MP3 Module (Red & Environmental-protection).pdf
