HAMES-6-4th/smart-bus-access/docs/인터페이스 & 모듈 설계서/하차벨 모듈.pdf

# 하차벨 모듈 - Bluetooth기반 교통약자용 버스 전동문 및 전동경사로 소규모 통 합 제어 시스템

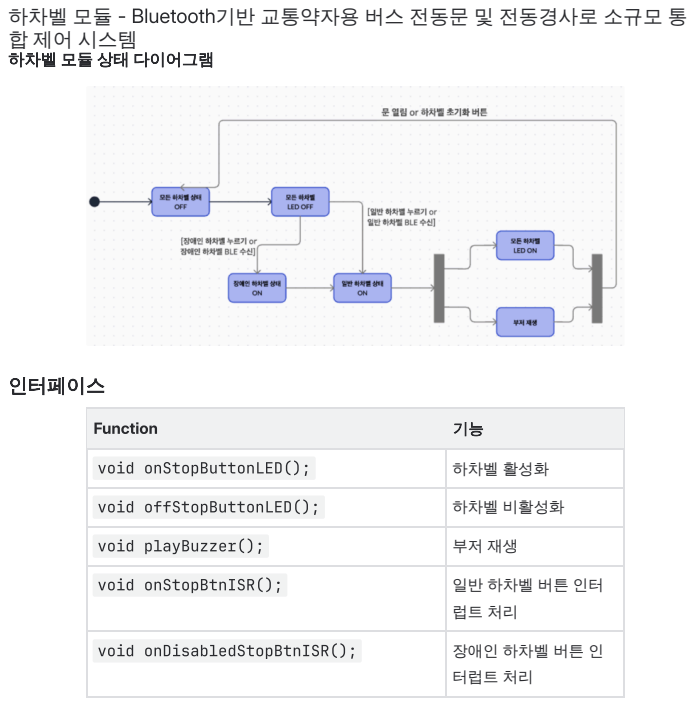
[picture p104: page 1]
인터페이스

하차벨 모듈 상태 다이어그램

Function | 기능

void onStopButtonLED(); | 하차벨 활성화

void offStopButtonLED(); | 하차벨 비활성화

void playBuzzer(); | 부저 재생

void onStopBtnISR(); | 일반 하차벨 버튼 인터 럽트 처리

void onDisabledStopBtnISR(); | 장애인 하차벨 버튼 인 터럽트 처리
