HAMES-6-4th/smart-bus-access/src/driver-ecu/stop_bell.c

/*********************************************************************************************************************/
/*-----------------------------------------------------Includes------------------------------------------------------*/
#include "stop_bell.h"
/*********************************************************************************************************************/

/*********************************************************************************************************************/
/*------------------------------------------------------Macros-------------------------------------------------------*/
/*********************************************************************************************************************/

/*********************************************************************************************************************/
/*-------------------------------------------------Global variables--------------------------------------------------*/
extern StopBtnState g_stopBtnState;
extern DisabledStopBtnState g_disabledStopBtnState;

extern bool buzzerOn;
extern uint64 buzzerStart;

extern uint8 monitorFlags;


/*********************************************************************************************************************/

/*********************************************************************************************************************/
/*--------------------------------------------Private Variables/Constants--------------------------------------------*/
/*********************************************************************************************************************/

/*********************************************************************************************************************/
/*------------------------------------------------Function Prototypes------------------------------------------------*/
/*********************************************************************************************************************/

/*********************************************************************************************************************/
/*---------------------------------------------Function Implementations----------------------------------------------*/
void onStopButton(void)
{
    if(g_stopBtnState == STATE_STOP_BTN_OFF)
    {
        g_stopBtnState = STATE_STOP_BTN_ON;
        IfxPort_setPinHigh(STOP_LED_1.port, STOP_LED_1.pinIndex); // LED ON
        monitorFlags |= 0x10;
        playBuzzer();
    }
}

void offStopButton()
{
    if(g_stopBtnState == STATE_STOP_BTN_ON)
    {
        g_stopBtnState = STATE_STOP_BTN_OFF;
        g_disabledStopBtnState = STATE_DISABLED_STOP_BTN_OFF;
        IfxPort_setPinLow(STOP_LED_1.port, STOP_LED_1.pinIndex); // LED OFF
        monitorFlags &= 0xEF;
    }
}

void playBuzzer()
{
    IfxPort_setPinHigh(BUZZER.port, BUZZER.pinIndex);
    buzzerOn = true;
    buzzerStart = IfxStm_get(&MODULE_STM0);
}

/*********************************************************************************************************************/
