HAMES-6-4th/smart-bus-access/(commit log)

2026-04-01 feat: 장애물 탐지
    STM 스케줄러 기반 장애물 탐지 + 디버깅용 UART 출력
2026-04-01 문 열고 닫기 제어 시스템 구현(v1.0)
2026-04-01 feat: 문 개폐 제어
2026-04-01 feat: 슬로프 제어
2026-04-03 feat: 충격 감지
    feat: 충격 감지
2026-04-03 feat: 슬로프 모터 제어
2026-06-08 docs: add project README and artifacts
    [4조_임베디드SW제어 프로젝트_산출물 (1).xlsx]
